fbcosentino/opensimpit/arduino_sketch/doc/nano.png

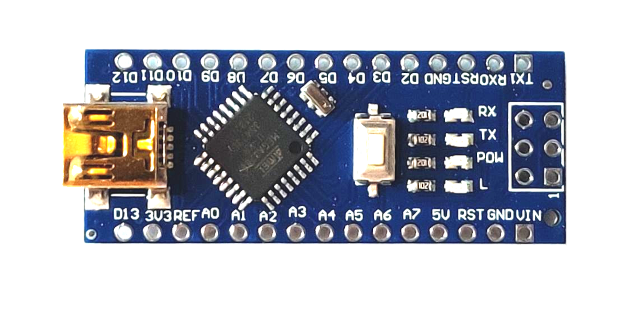
arduino_sketch/doc/nano.png
