fbcosentino/opensimpit/configuration_software/images/loading.png

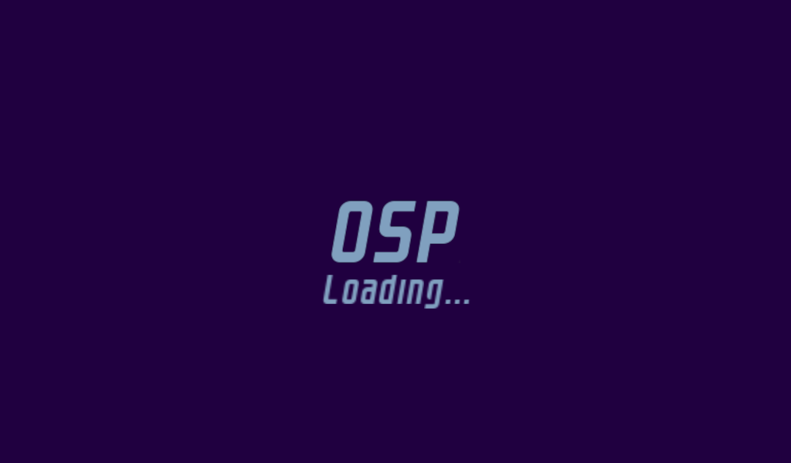
configuration_software/images/loading.png
