fbcosentino/opensimpit/(commit log)

2022-09-18 Main arduino sketch added
2022-10-02 arduino sketch updated to v0.2
2022-10-02 configuration software added (with binary release) alpha 0.2; godot plugin sdk added
    [export_presets.cfg, plugin.cfg]
2022-10-02 arduino sketch bug fixes: buffer too short for strings, LCC with wrong size check
    [opensimpit.ino]
2022-10-09 Radio Stack module added, arduino readmes, main sketch updated to read radios
2022-10-09 radios added to configurator software and python sdk
    [export_presets.cfg]
2022-10-09 flightgear python driver (draft) added
